LiaoZiqi-GZFLS/nscscc2026-loongarch-cpu/logs/README.md

# Hardware Test Logs

This directory stores concise summaries and raw UART captures from the FPGA
hardware tests. Large Vivado transaction logs stay outside the repository.
