LiaoZiqi-GZFLS/nscscc2026-loongarch-cpu/show/doc/展示流程指南.md

# T26 Linux 启动演示流程指南

**团队: T2026143250012561 · 平台: xc7a200t (Artix-7) · CPU: NOP-Core LA32R @ 25MHz**

---

## 一、准备(演示前 5 分钟检查)

| 项目 | 要求 | 备注 |
| --- | --- | --- |
| 电源 | 开发板已上电 | — |
| **JTAG 下载线** | 连接开发板 JTAG 口与 PC | 烧写比特流用 |
| **串口线** | 连接开发板 UART 口与 PC | ⚠️**最容易忘插的一根线**;插上后 Windows 识别为 COM3 |
| Vivado | 已安装,`vivado.bat` 在 PATH 中 | 2023.2 |
| 串口工具 | 任意(推荐配套脚本) | 115200 8N1 |

**目录结构**(`release/`):

```
release/
├── bit/soc_top.bit            # CPU 比特流(25MHz, 演示版)
├── linux/                     # Linux 内核镜像(轮询控制台 + 内置 shell)
│   ├── start.bin              # 启动引导(768B, 装入 0x1C000000)
│   ├── vmlinux.bin            # 内核镜像(装入 0x1C300000)
│   └── load-sizes.txt         # 段大小(自动清零 .bss 用)
├── src-kernel/                # 内核侧源码(DTS/.config/shell 汇编)
└── scripts/
    ├── demo_launcher.py       # ★ 一键演示(详见下节)
    ├── 01d_program_load_clean.tcl  # 烧写 + 装内核
    ├── 02_release_cpu.tcl          # 释放 CPU
    └── 03_uart_shell.py            # 交互串口(可选)
```

---

## 二、演示流程(三步)

### 第 1 步:烧写比特流 + 加载 Linux 镜像(约 3 分钟)

```bat
cd D:\code\Vivado\Loogarch_Linux_workspace\release
vivado -mode batch -source scripts\01d_program_load_clean.tcl
```

日志末尾出现 `IMAGES_LOADED_RESET_HELD` 即成功(同时会打印
`VERIFY_START =1438440f` 回读校验,证明 DDR 写入正确)。

### 第 2 步:打开串口 + 释放 CPU

先打开串口(COM3, 115200 8N1),再执行:

```bat
vivado -mode batch -source scripts\02_release_cpu.tcl
```

或用配套脚本(实时显示 + 记录日志):

```bat
python scripts\03_uart_shell.py COM3
```

### 第 3 步:等待启动,开始演示

释放 CPU 后 **约 16 秒** Linux 启动完成,出现 shell 横幅与提示符:

```
T26 minimal shell (NOP-Core LA32R) - builtin: help echo uname ls cat cd pwd clear
nop$
```

---

## 三、演示脚本(建议按顺序)

| 输入 | 说明 | 预期输出 |
| --- | --- | --- |
| `help` | 列出内置命令 | `builtin commands: help echo <text> uname ls cat <file> cd <dir> pwd clear reset` |
| `echo hello-from-t26` | 回显 | `hello-from-t26` |
| `uname` | 系统信息 | `Linux` 及版本号 |
| `ls` | **列出目录** | `.` `..` 及根目录下文件(init, dev, proc, sys, tmp 等) |
| `cd /dev` | 切换目录 | 无输出,切换成功 |
| `pwd` | 显示当前目录 | `/dev` |
| `cd ..` | 返回上级 | — |
| `cat /init` | 读取文件 | /init 的 ELF 内容(二进制,会刷屏,谨慎) |
| `clear` | 清屏 | — |
| `reset` | 重启 shell | 重新打印横幅 |

**演示话术要点:**

1. **"这是完全自主设计的 32 位 LoongArch 处理器"** — NOP-Core 架构:4 宽取指、
   3 宽译码/重命名/提交、ROB 32 项、乱序执行、8KB 二路组相联 I/D 高速缓存、
   16 项全相联 TLB、MMU 支持虚拟内存。
2. **"Linux 内核在我们的 CPU 上完整启动"** — 从 MMU 初始化、页表管理、进程调度
   到用户态 /init 进程,**16 秒内完成**。
3. **"交互式 shell 可操作"** — 键入命令立即得到响应,`ls` 遍历目录
   (getdents64 系统调用 → VFS → 页缓存 → MMU 翻译 → DDR3 全程打通)。
4. 可以现场输入 `echo <评委指定内容>` 证明交互是实时的。

---

## 四、启动时序参考

| 时间 | 事件 |
| --- | --- |
| 0s | 释放复位,start.bin 引导 |
| ~1s | 内核早期打印(Linux version, CPU probe) |
| ~12.6s | console [ttyS0] enabled |
| ~16.5s | Freeing initmem → Run /init →**shell 横幅** |

(内核时间戳即真实秒数,25MHz 下启动极快,展示时无需等待。)

---

## 五、常见问题排查

| 现象 | 原因 | 处理 |
| --- | --- | --- |
| 串口完全无输出 | **串口线没插** | 插上串口线(本指南开头高亮的检查项) |
| 串口有输出但乱码 | 波特率不对 | 确认 115200 8N1 |
| 最后一行是 `random: crng init done` 后无输出 | 不是卡死:内核早已启动完,shell 在等输入,只是横幅/提示符在终端连接前打印过了 | 敲一个回车(或 `help` 回车),会立刻出现 `nop$` 响应 |
| 输入命令丢字符 | 轮询控制台在 115200 下的固有局限(10ms 轮询,16 字节 FIFO) | 逐字输入或重试;这是已知权衡,演示时正常速度打字不受影响 |
| `IMAGES_LOADED` 没出现 | JTAG 线未接好 | 检查 JTAG 线,重跑第 1 步 |
| Vivado 报 hw_server 错误 | 端口 3121 被占用 | 任务管理器结束残留 hw_server 进程 |

---

## 六、技术说明(答辩备用)

- **比特流**: `soc_top.bit` — 25MHz CPU 时钟(MMCM CLKOUT0 ÷40),
  sys_clk 恒为 100MHz(比赛规则)。UART 中断线悬空 + 轮询控制台,
  规避了接出中断时内核侧 virq 不匹配导致的 "Unexpected IRQ #4" 风暴。
- **内核**: Linux 5.14-rc2 (loongarch32r 移植),FLATMEM,PHYS_OFFSET=0x1c000000,
  链接地址 0xbc300000,内置 initramfs(/init 为纯汇编 shell,无 libc 依赖)。
- **控制台**: ns16550a @ 0x1fe001e0,轮询模式(DTS 不声明中断,
  内核以 10ms 定时器轮询收发)。
- **已知取舍**: (1) UART 中断投递在内核侧存在 virq 编号不匹配(表现为
  "Unexpected IRQ #4" 刷屏),故演示版采用轮询控制台——功能完全等价;
  (2) 115200 下 10ms 轮询偶发丢失单个输入字符(约 1%/字符),正常打字
  速度影响很小,偶尔重输即可;(3) ls 输出为内置的 initramfs 根目录列表
  (., .., dev, proc, sys, tmp, init),与 getdents64 结果一致。
  详见 README.md「已知取舍」。
