LiaoZiqi-GZFLS/nscscc2026-loongarch-cpu/sw/linux/out/initramfs_list.txt

dir  /bin   755 0 0
dir  /sbin  755 0 0
dir  /dev   755 0 0
dir  /proc  755 0 0
dir  /sys   755 0 0
dir  /etc   755 0 0
dir  /tmp   755 0 0
dir  /mnt   755 0 0
nod  /dev/console 600 0 0 c 5 1
nod  /dev/null    666 0 0 c 1 3
nod  /dev/ttyS0   600 0 0 c 4 64
file /bin/busybox /home/kimi/build/rootfs/bin/busybox 755 0 0
file /init /home/kimi/build/rootfs/init 755 0 0
slink /bin/sh /bin/busybox 777 0 0
slink /bin/ls /bin/busybox 777 0 0
slink /bin/mount /bin/busybox 777 0 0
slink /bin/cat /bin/busybox 777 0 0
slink /bin/echo /bin/busybox 777 0 0
slink /bin/ps /bin/busybox 777 0 0
slink /bin/pwd /bin/busybox 777 0 0
slink /bin/mkdir /bin/busybox 777 0 0
slink /bin/cp /bin/busybox 777 0 0
slink /bin/mv /bin/busybox 777 0 0
slink /bin/rm /bin/busybox 777 0 0
slink /bin/dmesg /bin/busybox 777 0 0
slink /bin/uname /bin/busybox 777 0 0
slink /bin/hostname /bin/busybox 777 0 0
slink /bin/env /bin/busybox 777 0 0
slink /bin/ln /bin/busybox 777 0 0
slink /bin/chmod /bin/busybox 777 0 0
slink /bin/sync /bin/busybox 777 0 0
slink /bin/reboot /bin/busybox 777 0 0
slink /bin/poweroff /bin/busybox 777 0 0
slink /bin/free /bin/busybox 777 0 0
slink /bin/vi /bin/busybox 777 0 0
slink /bin/clear /bin/busybox 777 0 0
slink /bin/grep /bin/busybox 777 0 0
slink /bin/find /bin/busybox 777 0 0
slink /sbin/init /bin/busybox 777 0 0
