LiaoZiqi-GZFLS/nscscc2026-loongarch-cpu/sw/linux/out/verification.txt

T2026143250012561 sw/linux 构建验收记录（双变体，第三轮：补丁 0008 cache 几何）
==============================================================================
构建机: x86_64 Debian 12, 2 核；工具链 gcc 8.3.0 ilp32s (LA32 v2.0 20230903)
内核: la32r-Linux @ 4ed7b98e08e8d9628f8d39a21ca8bbdd29ad8d1e
busybox 1.36.1 静态；补丁 0001~0008 全部应用（board-16m 另加 0004）

[补丁 0008 cache 几何]
  probe_pcache config: 0xfe994cd3 (16B/256sets/2way) -> 0xfe2914d3 (64B/64sets/2way)
  解码自检（内核公式）: I: linesz=2<<5=64 sets=64<<0=64 ways=1+1=2
                        D: linesz=2<<5=64 sets=64<<0=64 ways=1+1=2  ✓
  waybit: ffs(4096)-1 = 12（修复原恒 0 导致 blast 全清只刷 way 0 的 bug）
  blast_dcache16() 两处调用点 -> blast_dcache64()；新增 cache64_unroll32
  （32 cacop × 64B 步长 = 2KB/unroll）
  其余 16B 假设点排查：无其它汇编 cacop 循环；blast_*_range 走运行时
  cpu_dcache_line_size()；CONFIG_L1_CACHE_SHIFT=6（64B）本就正确；
  BX_SOC 专属 local_flush_cache_all 不在本配置编译。

[verilator-flow]（chiplab verilator 官方流程，RAM 0 起 128MB）
  vmlinux: ELF32 LoongArch EXEC, entry 0xa0b84b10, .text vaddr 0xa0300000
           -> 物理加载 0x300000
  AM* 原子指令: 0（objdump 全扫）
  vmlinux.bin = 13,340,888 B；start.bin = 768 B

[board-16m]（nscscc-team 最小 SoC，16MB DDR @ 0x1c000000）
  vmlinux: ELF32 LoongArch EXEC, entry 0xbc593b40, .text vaddr 0xbc300000
           -> 物理加载 0x1c300000（DDR 窗内 ✓）
  AM* 原子指令: 0（objdump 全扫）
  vmlinux.bin = 5,721,304 B；bss = 0x7111c；内核镜像末端 ≈ 0x1c8f111c
  剩余可用 RAM ≈ 7.0MB / 16MB 窗
  内嵌 dtb 二进制验证: memory reg <0x1c000000 0x01000000> ✓、
  uart clock-frequency=100000000 ✓
  start.bin 反汇编验证: 跳转目标 0xbc593b40 ✓、argv 指针 0xbc0000dc/de ✓

[共用]
  rootfs.cpio.gz = 1,312,981 B，newc 解析：bin/busybox(2.33MB)、bin/sh、
  bin/ls、bin/mount、bin/cat、init、dev/console、dev/null、dev/ttyS0 全在 ✓
  命令行: console=ttyS0,115200 rdinit=/init loglevel=8（UART 100MHz/除数54）
