LiaoZiqi-GZFLS/nscscc2026-loongarch-cpu/show/soc/official-bits/clock_timing_validation_100mhz.txt

build_kind=perf
requested_cpu_mhz=100.0
actual_cpu_mhz=100.000000
actual_sys_mhz=100.000000
actual_ddr_mhz=200.000000
setup_wns_ns=0.089000
hold_wns_ns=0.050000
