LiaoZiqi-GZFLS/nscscc2026-loongarch-cpu/(commit log)

2025-08-18 2024 final submission
    [final_score.xlsx, score.xlsx]
2025-08-18 add ci
    [final_score.xlsx]
2025-08-18 fix xlsx
    [final_score.xlsx]
2026-07-29 score: update OpenLA500 33 MHz reference
    [final_score.xlsx]
2026-07-29 score: refresh OpenLA500 reference
    [final_score.xlsx]
2026-07-29 score: add system counter ratio
    [final_score.xlsx, score.xlsx]
2026-07-31 cpu: 双发射乱序超标量 LA32R 处理器 v2.10（func 58/58 双环境回归）
    - 取指4/分派2/发射2/写回4/提交2，ROB32+IQ16+PRF64
    - BPU: BTB128行粒度+GShare+RAS8；8深重命名检查点一拍恢复
    - ICache 16KB 2路四行refill；DCache 8KB直映射WT+SB4
    - 选择性前递哲学：常见路径全前递，罕见情况（csr/llsc/syscall/ertn）串行点
    - verilator lean 298,664拍 / SoC 299,861拍，iverilog 逐拍一致
    - yosys xc7 复测最深8级LUT（IQ16发射选择），缓存/前端/预测器零侵蚀
2026-07-31 perf: CPU 主频申报 100MHz（首跑基线，WNS 报告到手后再调）
2026-07-31 fix: 顶层 module 名改回 core_top（soc_top.v:547 例化名为 core_top；文件名保留 mycpu_top.v 满足路径契约）
    CI pipeline #594 synth_1 报错 [Synth 8-439] module 'core_top' not found。
    README 要求的 src/mycpu/mycpu_top.v 是文件路径契约，Vivado 按 module 名解析。
    纯符号变更，verilator lint 通过，功能零影响。
2026-07-31 perf: CPU 主频申报 100→30MHz（pipeline #603 实测 WNS 诊断）
    实测数据（job 2100/2101 artifacts）：
    - perf @100MHz: setup WNS=-16.895ns，cpu_clk 域 78871/128492 端点失败
    - func @32.7MHz(模板默认): setup WNS=-0.776ns
    - worst path: exwb0_valid→IQ entry_uop 写，26.75ns（33级逻辑，布线占84.5%）
    - 物理极限≈37MHz；30MHz 申报留 ~6.5ns 余量
    频率不进评分公式（cpu_count=周期数），DDR wall 延迟折算随降频减少，
    starv_frontend 46% 画像下降频对分数微赚。
2026-07-31 perf: CPU 主频申报 30→25MHz（pipeline #614 @30MHz WNS=-0.567ns）
    Vivado 目标驱动行为实测（同 RTL 三次构建）：
    目标100MHz→路径26.75ns / 目标32.7MHz→31.34ns / 目标30MHz→33.90ns
    工具'达标即止'，申报频率必须给足目标余量。
    25MHz 周期40ns，对33.9ns路径余量~6ns。
2026-08-01 fix: C6 补洞——已提交(granted) store 阻塞一切 load（修板上 func 43/44 ld.bu/ld.hu 陈旧读）
    ROB 满(cnt=32)时，刚提交 store 的槽位 pos_sb 可达 31 < 32=cnt，
    被 C6 年龄比较误判为'ROB 内更年轻 store'而放行 load → load 抢在
    更老 store drain/invalidate 前读 dcache，命中陈旧行或 refill 抢 W
    前读到 DDR 旧值。AXI 延迟下 ld.bu 与 st.w 的 W 握手 invalidate 同拍
    抢 tag 读口，读到上一个测试点残留数据 → 43/44 静默失败 → r26=56≠58
    → 结尾 syscall 活锁（板上 func 56/58、perf 0/20）。
    修复：IQ C6 增加 sb_g（已提交授权位）——已提交 store 必然比 ROB 内
    任何 load 老，无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
2026-08-01 fix: 补译码 cpucfg/cacop/dbar/ibar——修板上 perf 0/20 全死
    根因：perf start.S 第 2 条指令即 cpucfg（cache 探测），本设计 decoder
    未实现 -> EXC_INE。此时 EENTRY 复位值=0x0（start.S 在 cpucfg 之后才
    写 EENTRY=0x1c000380），异常跳 0x0 执行 DDR 垃圾 -> CPU 全死，
    perf 20 项 num_data=0x0 全超时（pipeline #651/#617 实证）。
    修复：
    - cpucfg rd,rj（inst[31:10]==22'h1b）-> FU_CSR/AOP_CPUCFG，恒返回 0
    （上报无 I/D/L2 cache -> start.S 跳过全部 cacop 初始化循环）
    - cacop（inst[31:22]==10'b0000011000）-> 串行 NOP（write-through
    dcache 无需动作；serial 等 ROB 排空自带屏障语义）
    - dbar/ibar（inst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
2026-08-01 fix: 复位自清——修板上 func/perf 全部 total-death（num_data=0 超时）
    根因（板级启动流程实证复现）：板上每次测试的流程是"上电自由跑 →
    JTAG 下载程序+复位 CPU → 重启"。本设计三处关键状态靠 initial 初始化，
    而 FPGA 的 initial 只在配置后生效一次，JTAG 复位不会重新执行：
    1. prf ready_r（全 ready）：复位瞬间若有在途写回（ready_r[x]=0），复位后
    rename 初始映射 arch i->phys i（0-31）继承 ready=0 -> 读该 arch 寄存器
    的指令永远等不到 ready -> issue 死锁
    2. icache tag valid：自由跑期间缓存的旧 DDR 内容（复位向量 0x1c000000
    与自由跑取指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
2026-08-01 fix: 四处 OoO 正确性修复——本地 perf 仿真首通(Test Success)+func 58/58 回归
    - frontend.v(Bug#5 主修复): req_valid 加严格单在途 (!inflight||resp_valid)。
    原假设 hit固定1拍+miss时ic_busy冻结 有洞: ic_busy 拉高前 miss 块
    下一行 req 已发出并覆盖 bq_*_r, 延迟 resp 用错块 {off,cat,tgt} 截断
    重定向; 截断点非分支时 EX 永不校验, 错径直接提交(实测 strlen 第4条后
    瞬移到 RAS 污染目标, sp 失衡, epilogue 读错 ra → INE 死循环)。
    - issue_queue.v(C7): store 严格年龄序发射——年轻 store 填满 sb 而最老
    store(常为 ROB 头)被挡 → 全机死锁。
    - rob.v: ROB 满(tail==head)时 5-bi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
2026-08-01 diag: AXI 信标——板上 perf 卡死分类上报(临时诊断,评分前移除)
    复位后 200M 拍若程序未写 NUM_ADDR(func/健康 perf 会写,天然抑制),
    夺取 AXI3 主口向 confreg 写:NUM<-最后AXI地址/最后提交PC, LED_RG0<-hang分类
    (01=无提交 10=早期崩溃 11=写过confreg后卡死)。本地 perf 仿真 Test Success
    (905929 commits/3803899 cyc 与信标前逐拍一致), func 不受影响(不写 NUM 才触发)。
2026-08-01 fix: Bug#7 checkpoint判龄改ROB环(板上perf全灭根因)+Bug#6 skid同拍丢写回
    Bug#7: rename.v 分支checkpoint槽seq(mod16)判龄在活槽seq有空洞时
    diff==8被误判为年轻→误释放更老分支的槽→槽复用后老分支误预测恢复
    他人快照→幽灵fRAT映射指向已死生产者→prf_rdy永不置位→消费者永久
    等待→全核冻结。load-to-branch延迟被CDC/DDR拉长后必现(板上perf 0/20,
    本地CDC harness复现于bitcount cyc~6.33M)。修复: younger_mask改用
    ROB环形区间判龄(ck_rob∈(bru_rob,rob_tail_cur), count≤31无歧义)。
    Bug#6(附带): 1深skid在lsu_done/mdu_done与skid_v同拍时覆写/丢弃写回。
    修复: lsu_struct/mdu_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
2026-08-02 fix: Bug#8-11 四个 OoO 正确性修复——本地 perf 20/20 全通
    Bug#8 IQ load/更老store 序补洞：load 在更老 store 仍滞留 IQ（未进 sb）
    时不得发射（bubble_sort 交换序列陈旧读→自检失败根因）
    Bug#9 ROB 满(tail==head)时 in_range 全假：分支 flush 杀不到投机项→sb
    污染/freelist 泄漏→全局死锁（dhrystone/coremark wedge 根因）。
    lsu/ex_mdu/rob/rename 四处统一改 (tag-from-1)<(tail-from-1) 形式
    Bug#10 lsu_done/mdu_done 当拍入结构门控：done 拍 skid_v 未置位、FSM 已
    空，放行新发射会与 pending skid 碰撞丢写回（fireye_B2/C0 FATAL）
    Bug#11 serial_lock 解锁改 serial_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
2026-08-02 perf: dcache 重写为 write-back/write-allocate（参考 OpenLA500, Mulan PSL v2）
    - store hit 决策拍写 BRAM + 同拍回 B，不占 AXI（原 write-through 每 store 一笔 DDR 往返）
    - store/load miss write-allocate：脏 victim 先写回 burst(awlen=3) 再 refill；末拍 merge+回 B/rvalid
    - tag_ram 扩 21bit {valid,dirty,tag}；删除 store invalidate 逻辑；uncached 单拍透传不变
    - axi_arbiter 写通道支持 burst（ls_awlen/ls_wlast，w_pend 末拍置位）
    - 本地回归 20/20 PASS，store 密集型 cycles 降 8~21%（理想 RAM；板上 DDR 收益更大）
    - 设计报告需声明：dcache 参考 OpenLA500 (gitee loongson-edu/open-la500, Mulan PSL v2)
2026-08-02 frontend: predecode second-chance branch prediction
    - B/BL immediate-redirect at resp stage when BTB misses
    - cond branches (fwd+bwd) directed by trained PHT via exact branch-PC hash
    - JIRL ret-pattern (r0,r1,offs=0) predicted via RAS pop
    - bpu: add q_hit and q2 query port (q2_dir/q2_ras_top/q2_ras_empty)
    Local: coremark flush 41036->33135, stream_copy ~10.5K->616, bubble 14747->11135; regression 20/20
2026-08-02 lsu: pipeline as 2-slot x/y stages (1 load/2cyc sustained, store 1/cyc)
    - accept->x(addr/ALE/kill)->y(AR/R/done); load throughput 2x, stores overlap
    - phantom sb entry injects oldest in-flight store to C6 (fixes 2-cycle C6 gap)
    - done_hold backpressure covers next-cycle skid set race
    - sb/flush-compress/IQ C6/C7 unchanged; cpu_core: +done_hold wire only
    - Pipeline structure refers to NOP-Core (MIT)
    Local: coremark -10.7%, bubble -18.7%, dhrystone -9.9%, stream_copy -12.9%; regression 20/20
2026-08-02 dcache: 2-way set associative (8KB, 2x256x16B) + refill target-word early forward
    - 2 ways x 256 sets; tag_ram 22b {valid,dirty,tag[19:0]}; index=addr[11:4]
    - victim: invalid-way first else per-set lru_bit; LRU updated on hit/refill
    - load refill: target-word beat combinationally forwarded (m_rdata) while
    line fill continues; store refill B still at last beat (merge needs full line)
    - interface/FSM encodings/downstream AXI unchanged; S_INIT 256cyc 2-way clear
    Local: stream 77387 (-2.6%), bubble 394809, coremark 921719 vs v3;
    dc refill stream 1414->1345 (way installs 58%/42%, assoc verified;
    local DM conflict low, board DDR latency is the real target); regression 20/20
2026-08-02 t26-nop: regenerate NOP netlist from source + add CPUCFG decode
    - mycpu_top.v regenerated from NOP-Core master via sbt/SpinalHDL 1.8.1
    (verified line-equivalent to official final submission netlist)
    - adds CPUCFG instruction decode (returns 0) so nscscc2026 perf start.S
    cache-geometry probing skips cacop init instead of trapping to PC=0
    - wrapper updated to public-source port names (intrpt, debug0_wb_*)
    - local verilator smoke: coremark runs to completion (exit routine,
    CONFREG count writeback, end state), IPC ~0.42 in sim
    [core_top.v]
2026-08-03 t26-nop: S3v2 @105MHz (m2sPipe + flushIt on jumpPipe.valid; local gates green: cyc860 fixed, coremark -0.98%, func 3 seeds ok)
    [core_top.v]
2026-08-05 submit: final design.pdf (16p) + filled score.xlsx + official bitstreams (func/perf from pipeline 1675); no RTL change (src/ untouched, still 7029bf9 content)
    [score.xlsx]
2026-08-05 t26-final: Linux boot support — CPUCFG const table + CSR PRCFG1/2/3 + IOCSR instrs
    - CPUCFG (ALU): per-rj constant table — word0 PRID=0x00144200 (5.14 kernel
    BUG_ON requires company 0x14), word1=0x0001f1fc (LA32R|PGMMU|IOCSR,
    PALEN=VALEN=31), word2 bit14 LLFTP, word4 CC_FREQ=105MHz, word5 MUL/DIV=1/1;
    cache-geometry words 0x10~0x14 stay 0 (2026 perf start.S skips cacop init
    on bit0=0; verified func init.S does not read cpucfg/iocsr)
    - CSR PRCFG1/2/3 read-only consts (0x3f4 / 0x1000 / 0xf1: SAVENum=4,
    TimerBits=63, VSMax=0; 4KB page; TLBType=1 + 16-entry MTLB-1)
    - IOCSR iocsrrd/iocsrwr .b/.h/.w: ALU path returns 0, writes ignored, no
    exception, added to privInst (IPE in PLV3)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
2026-08-05 docs: add runbook risk item — WNS@105MHz must be re-verified in Vivado (not verifiable in sandbox; CI deadline_guarded)
2026-08-05 sw/ucore: vendored ucore-loongarch32 adapted for LA32R NOP core + chiplab nscscc-team SoC
    Upstream: github.com/cyyself/ucore-loongarch32 @843f8b7 (master).
    Adaptations (see sw/ucore/PROVENANCE.md, all tagged '2026-final'):
    - link base 0xbc000000 = DMWIN0 window + chiplab DDR base 0x1c000000, KMEMSIZE 16MB
    - dual-mode entry trampoline (DA-mode bare-metal or PMON-style PG handoff),
    identity DMW via DMW1 (core implements DMW0/1 only)
    - timer period for 105MHz stable counter (100Hz)
    - UART16550 @0x1fe001e0 init per chiplab start.S (divisor=1)
    - poll UART RX from timer irq (SoC ties intrpt[7:0]=0)
    - CACHELINE_SIZE 64 (NOP core 64B lines), gnusf gcc _w CSR builtins
    Build: ./build.sh (gcc 8.3 gnu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
2026-08-05 final: add mini bootloader (sw/boot) for ucore/Linux chain-loading
2026-08-05 sw/linux: LA32R chiplab Linux 5.14 + busybox initramfs 适配层与构建产物
    - 内核 la32r-Linux@4ed7b98e (5.14.0-rc2) + la32_defconfig, 内嵌 initramfs
    - 补丁: LS_SOC 恒定频率计时器 200MHz->105MHz (arch/loongarch/include/asm/time.h)
    - busybox 1.36.1 静态 ELF32, rootfs 含 sh/ls/mount/cat + dev 节点 + init 脚本
    - boot/start.S 引导 stub (内嵌 argv/cmdline/bootparam, 与 chiplab 官方流程兼容)
    - out/: vmlinux(ELF32 LoongArch, strip), vmlinux.bin 13.3MB, rootfs.cpio.gz 1.3MB,
    start.bin, kernel.config, verification.txt (AM 指令=0, rootfs 含 ls)
    - build.sh 一键复现; mkrootfs.sh/mkimage.sh 生成 initramfs 与 rom.vlog
2026-08-05 sw/ucore: rev2 — real-board UART baud (DLL=0x36, DL3=0x40 @ sys_clk 100MHz)
    Integration fix (conflict with sw/boot @8660fb1 findings): chiplab 16550
    (Loongson URT) is clocked by sys_clk=100MHz (fixed by contest rules) and
    uses a 24-bit fractional divider baud=PCLK/16/dl; divisor=1 only works in
    verilator (its UART model ignores timing) and would garble real-board output.
    - console.c: write DLL/DLM + DL3 fractional register (reg offset 2 while
    DLAB=1), then 8N1, then FCR=0x47; -DUCORE_VERILATOR_UART keeps divisor=1
    - loongarch.h: COM1_BAUD_DLL/DLM/DL3 derived from UART_PCLK (default 100MHz,
    overridable -DUART_PCLK=<hz>) and UART_BAUD (115200) -> DLL=0x36, DL3=0x40,
    same values as sw/b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
    [loongarch.h]
2026-08-05 sw/linux: UART 100MHz 修正 + 新增 board-16m (16MB最小SoC) 构建变体
    - 0002: dts 串口时钟 33M->100M（chiplab 16550 挂 sys_clk=100MHz，除数54与bootloader衔接）
    - 0003: DMW 段长 256M->512M 修正（DMW_PABITS 29 + VSEG 常量 + TLBRENTRY/refill 掩码），
    否则 >=0x10000000 物理地址被截断，16MB SoC DDR@0x1c000000 必死
    - 0004: board-16m 变体 dts memory=<0x1c000000 0x01000000>
    - 0005/0006/0007: CONFIG_VT=n 裁剪编译/链接修复
    - board-16m: 裁剪 fragment（关NET/VT/MODULES等），链接地址 0xbc300000(物理0x1c300000)，
    vmlinux.bin 5.72MB+bss，16MB 窗内剩余 ~7MB；verilator-flow 变体重建（UART修正）
    - out/ 重组为 verilat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
2026-08-06 sw/linux: 补丁0008 修正内核 cache 几何为 64sets x 64B x 2way（匹配本核）
    - cache.c probe_pcache 硬编码 0xfe994cd3(16B/256sets) -> 0xfe2914d3(64B/64sets/2way)
    - 修复 waybit 全树恒 0 的 bug：blast 全清原本只覆盖 way 0，现按 waysize 计算(=12)
    - cacheflush.h 新增 cache64_unroll32 与 blast_*64 实例，blast_dcache16()->blast_dcache64()
    - 排查无其它 16B line 假设点（blast_range 走运行时 linesz；L1_CACHE_SHIFT=6 本就正确）
    - 双变体重建验收：ELF32、AM=0、dtb/start.bin 核验，verification.txt 更新
2026-08-06 sw: add finals system-test board bring-up runbook (top-level fact source)
2026-08-06 fix decode: add PRELD as nop (spec-compliant hint); keep CACOP privileged per LA32 spec — lab19 n52 is a NEMU-quirk test, not a CPU bug
2026-08-06 sw/linux: UART 100MHz fractional divisor (DLL=0x36, DL3=0x40) + DMW cached/uncached fix + rd_start cmdline; rebuild artifacts
2026-08-06 sw/linux: rebuild vmlinux/busybox artifacts for board-16m and verilator-flow
2026-08-06 sw/ucore: rebuild ucore artifacts (rev2 UART baud @100MHz)
2026-08-06 sw/board: add hardware bring-up tcl scripts (load/program/pulse/release/reset + axi probe)
2026-08-22 show: 决赛展示内容（Linux/ucore 演示阶梯 + 官方比特流 + 使用文档）
    - show/doc: demo.md 总体使用文档 + 展示流程指南
    - show/soc: CI 官方比特流（func/perf/sys）+ Linux 演示比特流与装载脚本
    - show/software: mini bootloader、ucore（含二进制）、Linux 5.14（镜像+内核侧源码+演示脚本）
    基线: t26-final（= CI 性能最强版 t26-submit@0fbfaa1 + 决赛系统测试链）
